jay1han/V2-Documents/Schema-global_4.png

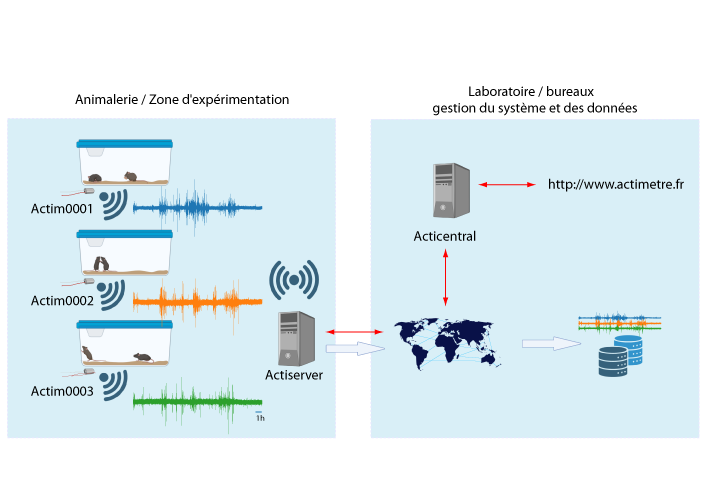
Schema-global_4.png
