jay1han/V2-Documents/V5 actimetre.FCStd

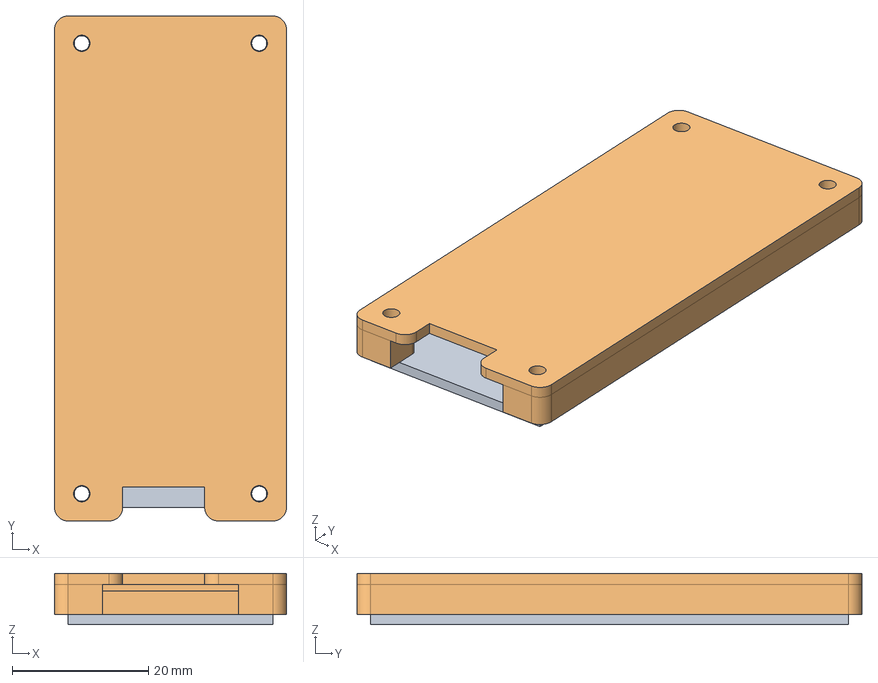
[picture p29: CAD file, 2025-03-25]
V5 actimetre.FCStd
34.0 x 74.0 x 7.50 mm
PCB
Cover
