jay1han/V2-Documents/Solo mini V5.FCStd

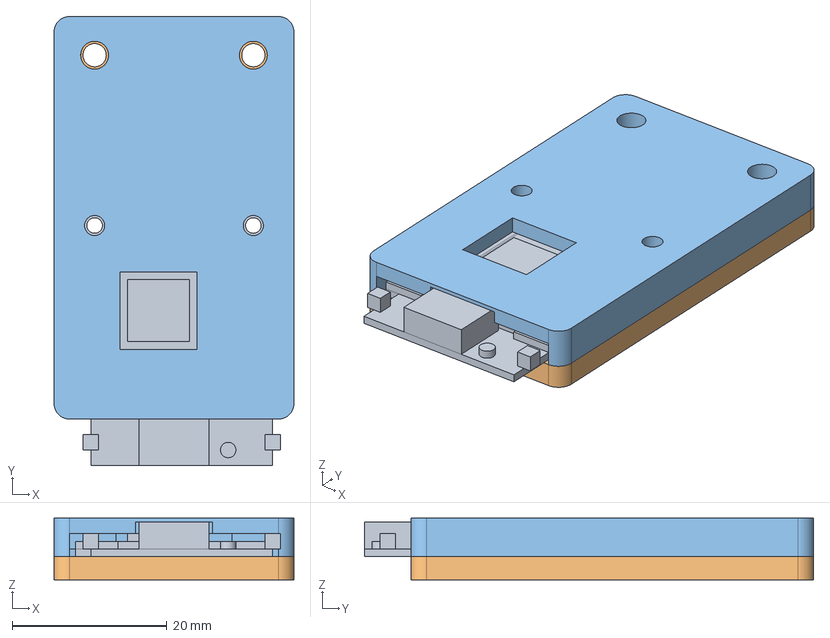
[picture p30: CAD file, 2025-03-25]
Solo mini V5.FCStd
31.0 x 58.0 x 8.00 mm
Mini
Plate
Cover
