jay1han/V2-Documents/S3 Zero.FCStd

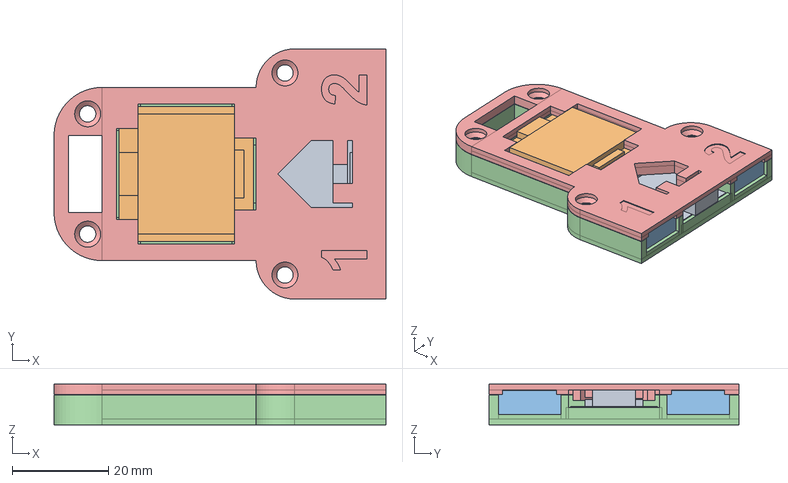
[picture p31: CAD file, 2025-02-12]
S3 Zero.FCStd
69.0 x 52.0 x 8.50 mm
S3
OLED
Connector1 x 2
Base
Cover
