jay1han/V2-Documents/Solo Zero V5.FCStd

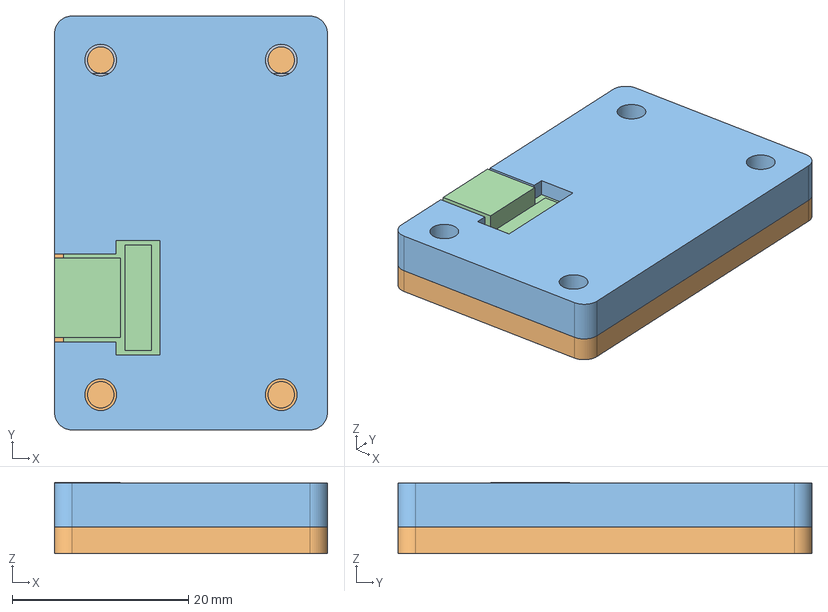
[picture p32: CAD file, 2025-02-12]
Solo Zero V5.FCStd
31.0 x 47.0 x 8.10 mm
Plate
Cover
S3
