jay1han/V2-Documents/Solo C3.FCStd

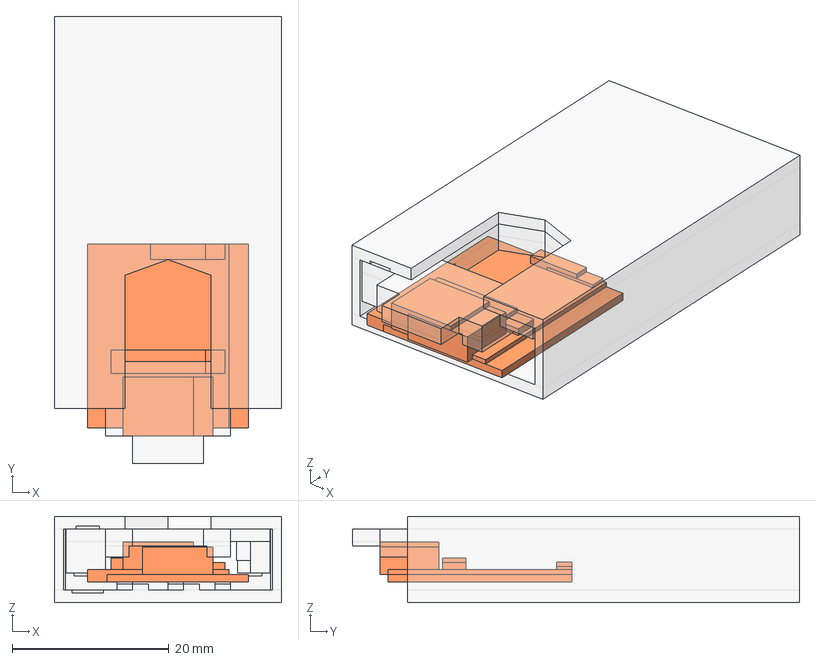
[picture p33: CAD file, 2024-05-24]
Solo C3.FCStd
29.0 x 57.0 x 11.0 mm
Supermini
C3
Sleeve
Tray
