jay1han/V2-Documents/V4.FCStd

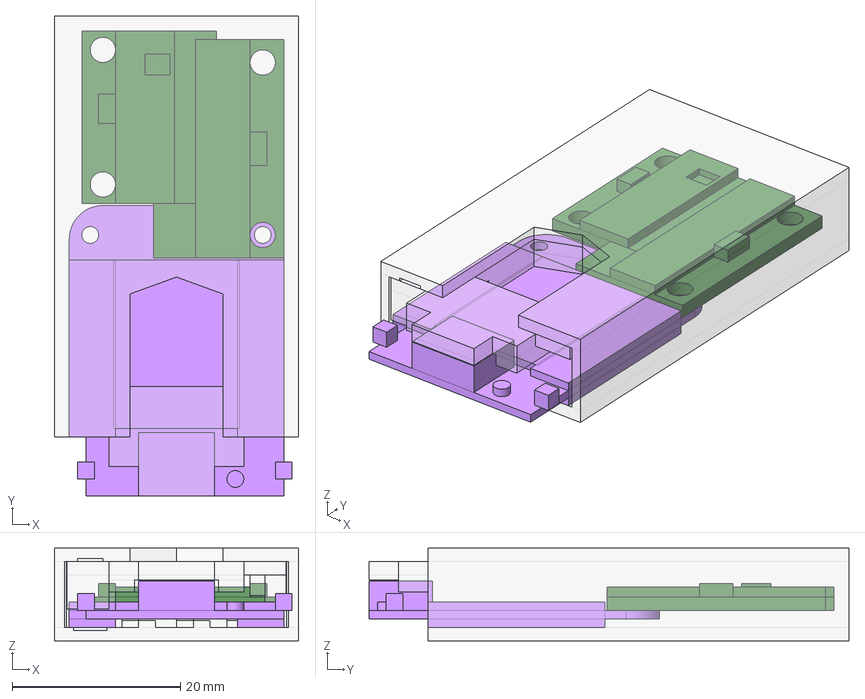
[picture p34: CAD file, 2024-05-09]
V4.FCStd
29.0 x 57.0 x 11.0 mm
Mini
Sleeve
Tray
