jay1han/V2-Documents/V3 mini.FCStd

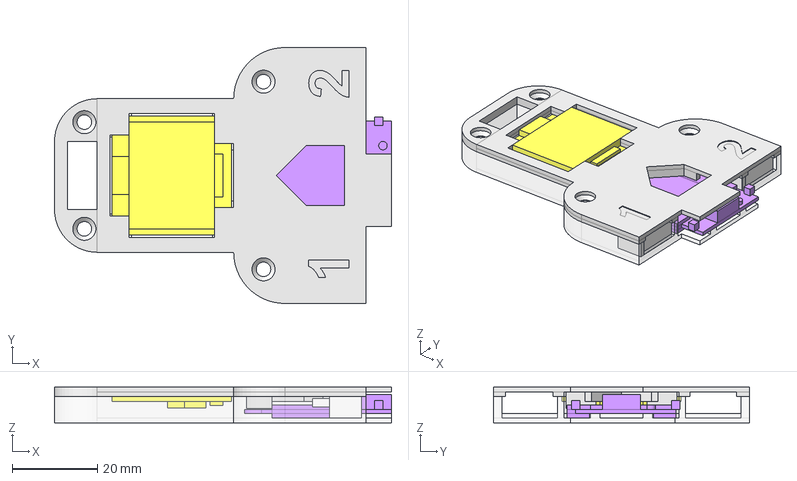
[picture p35: CAD file, 2024-04-23]
V3 mini.FCStd
79.0 x 60.0 x 8.40 mm
Base
Cover
OLED
Connector1 x 2
S3
