jay1han/V2-Documents/newbox.FCStd

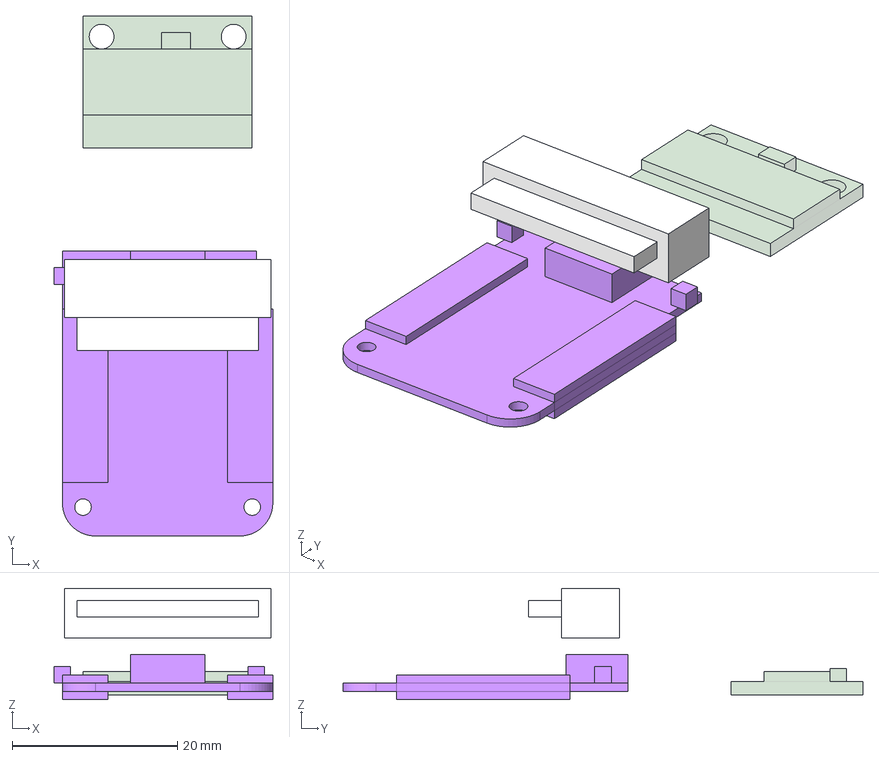
[picture p36: CAD file, 2024-03-25]
newbox.FCStd
26.5 x 63.0 x 13.5 mm
S3
Connectors
Sensor
