jay1han/V2-Documents/V3 backup.FCStd

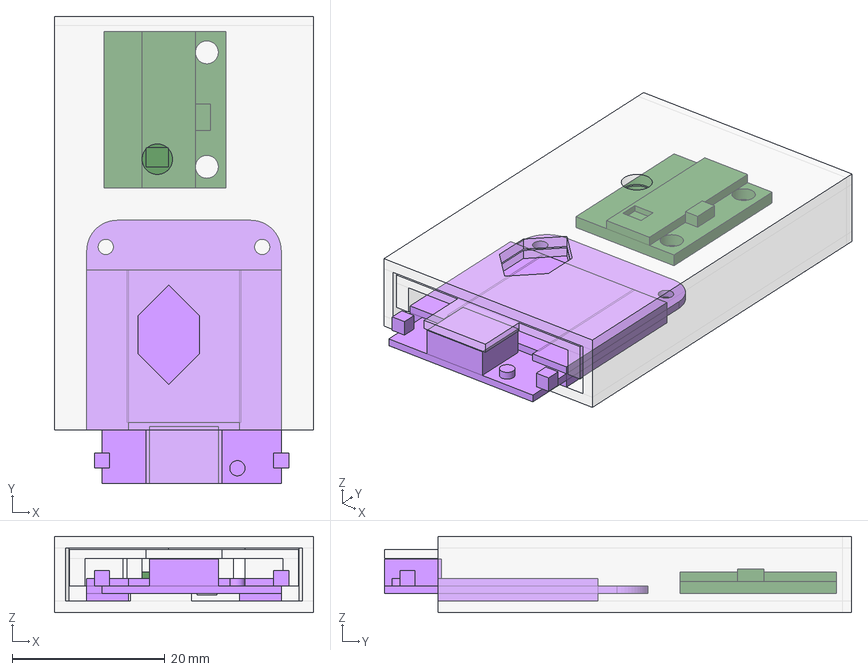
[picture p37: CAD file, 2024-03-22]
V3 backup.FCStd
34.0 x 61.2 x 10.0 mm
S3
Catch
Sleeve
