jay1han/V2-Documents/actimetre.FCStd

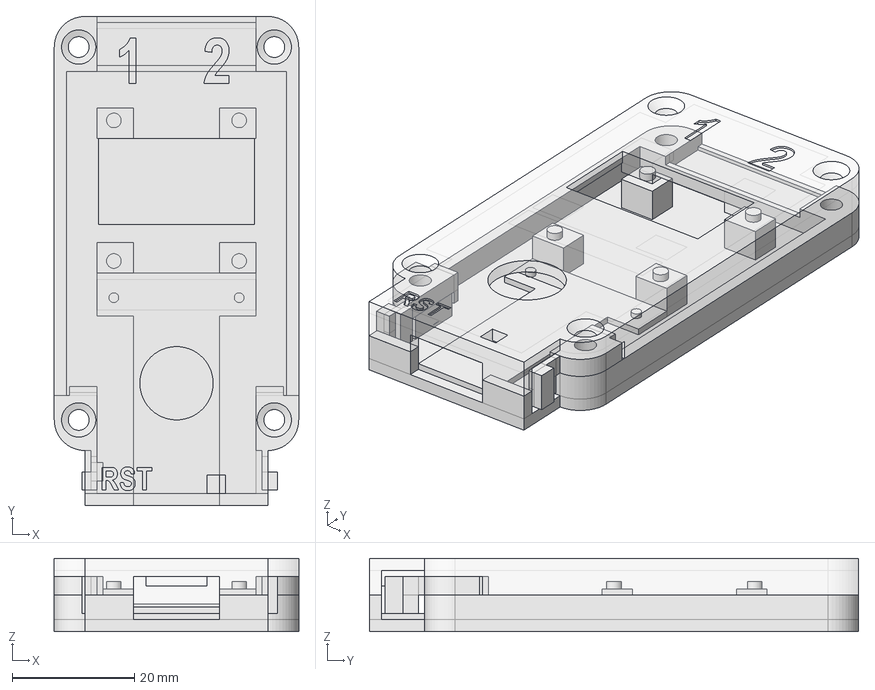
[picture p38: CAD file, 2024-03-05]
actimetre.FCStd
40.0 x 80.0 x 12.0 mm
Cover
Case001
Resetbuton
BootButton
