jay1han/V2-Documents/Solo mini.FCStd

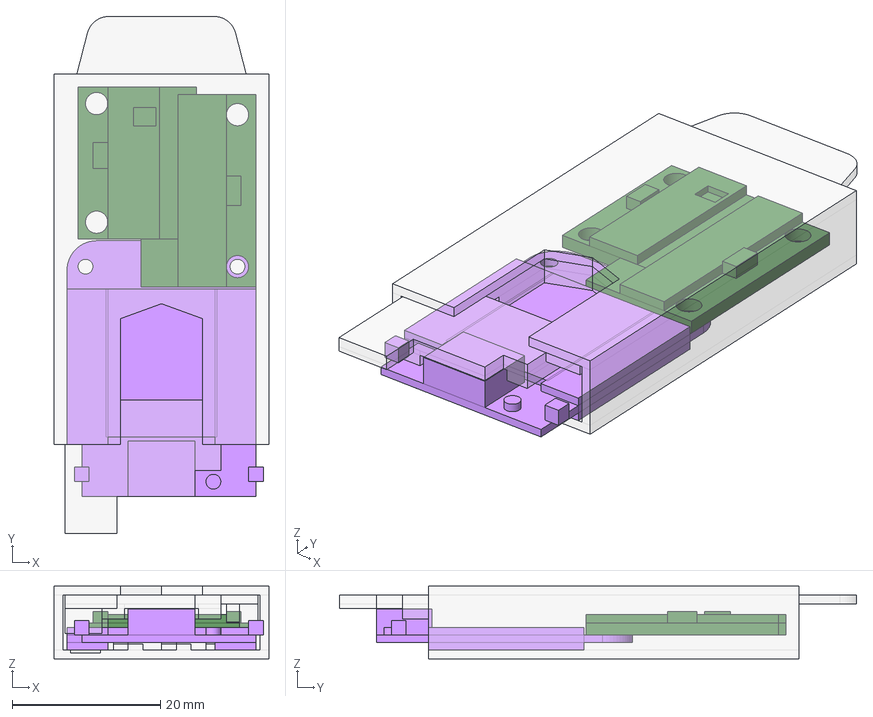
[picture p39: CAD file, 2024-05-26, an earlier design]
Solo mini.FCStd
29.0 x 69.8 x 9.80 mm
Mini
Sleeve
Tray
