jay1han/V2-Documents/V3.FCStd

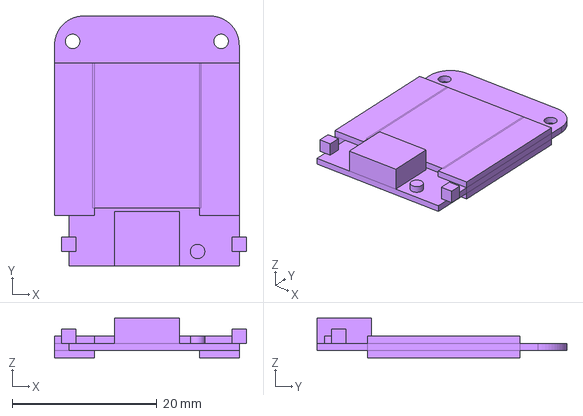
[picture p40: CAD file, 2024-04-23, an earlier design]
V3.FCStd
26.5 x 34.5 x 5.50 mm
