jay1han/V2-Documents/WiringsV5.pptx

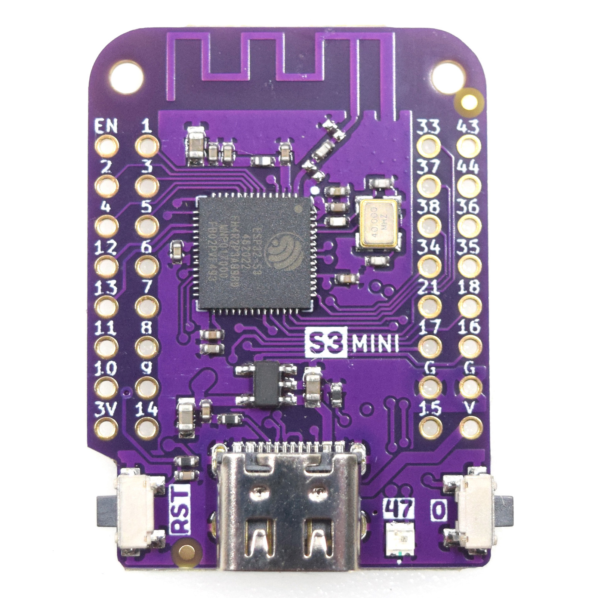
[picture p41: figure]
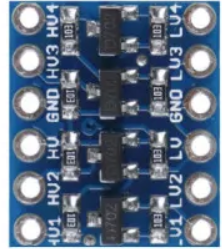
[picture p42: figure]

1K

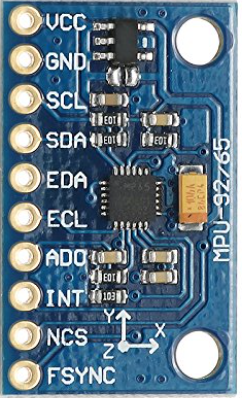
[picture p43: figure]

## Slide 2

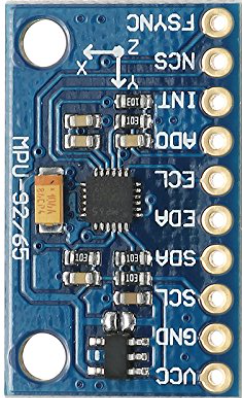
[picture p44: figure]
