jay1han/V2-Documents/Wirings.pptx

TOP_IMG

OLED Display
(I2C)

Sensors
1AB
(I2C)

Board ID

Sensors
2AB
(I2C)

3.3V

Ground

## Slide 2

## Slide 3


OLED Display
(I2C)

3.3V

Sensors
2AB
(I2C)

Sensors
1AB
(I2C)

Ground

## Slide 4

## Slide 5

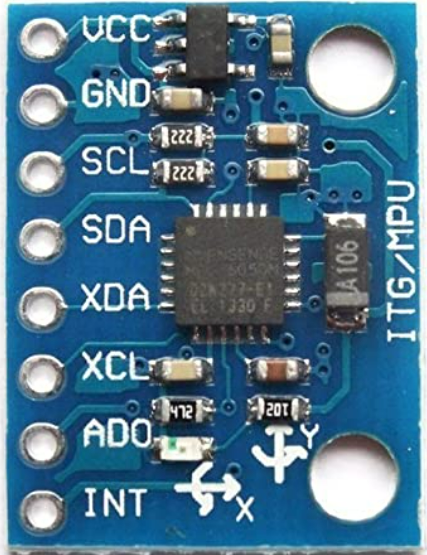
[picture p45: figure]

## Slide 6

B

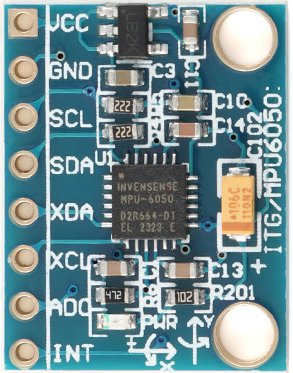
[picture p46: figure]

A

## Slide 7

New Box (V3)

Sensor
2AB
(I2C)

Sensor
1AB
(I2C)

## Slide 8

S3 supermini
(V3)

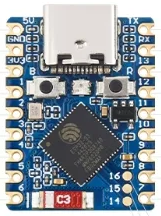
[picture p47: figure]

Pin 1 pull high

Sensor
1AB
(I2C)

Sensor
2AB
(I2C)
