jay1han/V2-Documents/(threads)

Thread 11 (2024-04-11):

ecrire un programme permettant e trier les fichiers de données

Bob690608, 2024-04-11:
Ce programme permettra de trier les milliers de fichiers de données contenus dans un répertoire en identifiant

- les actimetres et leur capteurs
- les séries de fichiers consécutifs (moins de x secondes entre la derniere ligne d'un fichier et la première ligne du suivant)
- la cage sur laquelle etait le capteur

jay1han, 2024-04-11:
More specifically:
- for each sensor, show the time segments corresponding to continuous measurement
- for each such segment, show the sampling frequency and data loss rate
- create a single file corresponding to a segment

On the other hand, relating segments with cage ID and project is left to the user

jay1han, 2024-05-01:
On estime qu'une interruption de moins de 5 minutes reste une acquisition continue, i.e. même projet et même cage.

jay1han, 2024-05-01:
Given a directory with files in a heap
- identify Actimetres and sensors
- clean up malformed lines
- isolate uniform acquisition segments (frequency, axes)
- clip & concatenate + rename
- create file list with metadata

Thread 15 (2024-04-11):

Clearinghouse: data file management

jay1han, 2024-04-11:
This issue is intended to obsolete #6 #3 #7 and is also related to #11

jay1han, 2024-04-11:
Requirement:
- Save data files securely and reliably to a designated network destination, then delete them from the Actiserver
- Put a given data file under a folder named after its corresponding project ID
- Further fan-out of the files to individuals or their computers is at the discretion of those individuals

Closed 2024-04-22.

Thread 16 (2024-04-11):

Detailed protocol for Actimetre management

jay1han, 2024-04-11:
Questions:
- How to create/modify/delete a project in the system?
- What are the key pieces of information attached to a project?
- How does an Actimetre get created/retired in the system?
- How does an Actimetre get assigned to/removed from a project?

Describe each operation in detail from the point of view of the actual operator

jay1han, 2024-04-11:
Assumptions:
- The Actimetre is the basic granularity for assignment to projects (not Actiservers, not individual sensors)
- The Actimetre system manager is responsible for adding/retiring Actimetres
- The project owner is responsible for managing the relationship between Actimetre-sensor and cage ID within the scope of his/her project

jay1han, 2024-04-20:
When an Actimetre is down, enable button to sync remaining files
When all files are cleared, Actimetre can be assigned to a different project

Closed 2024-04-22.

Thread 4 (2024-04-11):

Lancer un script externe à la clôture d'un fichier CSV

jay1han, 2024-04-11:
Nouvelle option de configuration SYNC_EXEC désignant le chemin complet du programme de sauvegarde de fichier. Ce programme sera appelé lorsqu'un fichier CSV est clos et doit être sauvegardé. Le programme est appelé avec un nom de fichier en paramètre. Ce fichier est présent dans le répertoire désigné par l'option REPO_ROOT (/media/actimetre par défaut).

jay1han, 2024-04-11:
Duplicate

jay1han, 2024-04-11:
Duplicate !!

Closed 2024-04-11.

Thread 5 (2024-04-11):

Dashboard shows the sensor model

jay1han, 2024-04-11:
In the format "1AB2AB" to show the attached sensors, lowercase a or b instead of uppercase signifies that the sensor is a MPU-6500 instead of a MPU-6050.
Note: the CSV file name is unchanged, will always use uppercase A or B

jay1han, 2024-04-17:
Branch "sensormodel" has been merged on Actimetre and Actiserver

Thread 6 (2024-04-11):

group datafiles in a subdirectory named after the project file

Bob690608, 2024-04-11:
Will help sorting datafiles

Bob690608, 2024-04-11:
- no risk to forget some datafiles in a given project
- datafiles unaffected (not normal) will appear at the root level
- the insertion of an actimeter in a project (or the removal from a project) will be a companion task to the management of mice cages

Bob690608, 2024-04-11:
eventually, when an actimeter is awakened after a time of inactivity (to be set in the anvironment variables), an alert is triggered on the dashboard to ask for the reassignation of the actimeter to the previous project

jay1han, 2024-04-11:
Need to refine the idea based on ultimate objective of this change.
Questions
- What if a project name changes
- What if the project name contains unacceptable characters for file path
- What is a good default for the time of inactivity

Alternate proposal: assign cage ID to sensor ID, then link cage ID to project. The CSV files will be stored in subfolders named after the cage ID. This assumes that there is a standard system for identifying cages. If there isn't please invent one.

jay1han, 2024-04-11:
This issue is obsoleted by #11

jay1han, 2024-04-11:
Consensus is to use the project ID (a number) as the folder name

Closed 2024-04-17.

Thread 7 (2024-04-11):

change data file names

Bob690608, 2024-04-11:
It will be more readable for a human like me to have the datestamp of the filename in a format more or less like %Y-%M-%D-%hh%mm%ss

jay1han, 2024-04-11:
To be more specific: YYYY-MM-DD-HHMMSS

Bob690608, 2024-04-11:
Prévoir aussi une interface (dashboard) pour insérer le numero de cage dans le nom des fichier etablir la correspondance Actimetre-capteur <-> ID_cage

Thread 23 (2024-04-20):

Test ESP32-C3

jay1han, 2024-04-20:

jay1han, 2024-04-20:
Single core, I2C at 400kHz. Can it handle 2 sensors at 1kHz or 1 at 4kHz?

jay1han, 2024-04-20:
Need special blinker

jay1han, 2024-04-22:
No hope here

Closed 2024-04-22.

Thread 24 (2024-04-20):

Actimetre file info in Project page

jay1han, 2024-04-20:

jay1han, 2024-04-21:
Manage files remaining from dead (unknown) Actimetre
Automatically call SYNC_EXE after one hour of inactivity
Trigger SYNC_EXE from dashboard

jay1han, 2024-04-22:
Test with sample SYNC_EXEC

jay1han, 2024-04-22:
When Actim goes out of Actis, finally clean up

jay1han, 2024-04-22:
Remove button and reset when Actim down

jay1han, 2024-04-22:
FIFO mixup: clear FIFO and count before resetting

jay1han, 2024-04-22:
Report initial state of /media/actimetre at startup

jay1han, 2024-04-22:
All done for v350

Closed 2024-04-22.

Thread 40 (2024-04-27):

SYNC_EXEC option behavior change

jay1han, 2024-04-27:
SYNC_EXEC is a plain string that is invoked as if typed in a console, with, if they are present, $0 will be replaced by the full path to the data file to sync, and $1 by the file name. For example, the configuration string “/usr/bin/mv $0 /dev/null” will result in the invocation of “/usr/bin/mv /media/actimetre/Actim0011-1A_2020-01-01_000000.csv /dev/null” while the configuration string “/usr/bin/mv $1 /dev/null” will result in the invocation of “/usr/bin/mv Actim0011-1A_2020-01-01_000000.csv /dev/null”. The file should be erased at the end of execution of this command before returning.

jay1han, 2024-04-27:
As per documentation

jay1han, 2024-04-27:
As per latest documentation, no change needed.

SYNC_EXEC is a plain string that is invoked as if typed in a console. If present, the substring $ will be replaced by the full path to the data file to sync. For example, the configuration string “/usr/bin/mv $ /dev/null” will result in the invocation of “/usr/bin/mv /media/actimetre/Project01/Actim0011-1A_2020-01-01_000000.csv /dev/null”. The file should be erased at the end of execution of this command before returning.

Closed 2024-04-27.

Thread 43 (2024-04-27):

Actiserver API for computation and data compression

jay1han, 2024-04-27:
Based on the following email:
```
from actiserver import actis_ext

def new_data(sensor_id, data):
    print(f'New data from sensor "{sensor}": {len(data)} items')
    # Traitement des données data

# Quelque part dans le processus principal
def main():
    actis_ext(sensor_id, len_data, new_data)
    # len_data is the number of data items new_data should be called with
    # call actis_ext(sensor_id) to de-register the callback
```

jay1han, 2024-04-28:
def actis_ext(sensor_id, period_ms, callback_fn)
# sensor_id is a string of the form "Actim0000-1A"
# period_ms is the period in millisecond
# callback_fn is a function of signature (sensor_id, sample_time, data), where sample_time is the datetime of the first element of data and data is a nparray of shape (period_ms, 6) of floats

jay1han, 2024-05-05:
Reuse SYNC_EXEC interface

jay1han, 2024-05-05:
case closed

Closed 2024-05-05.

Thread 48 (2024-04-30):

Fork S2/C3 version

jay1han, 2024-04-30:
Single core, so main loop alternates between reading fifo and sending packets.
Need to control time spent in data transfer so we don't overflow the fifo all the time.
All other protocols compatible to v35x

jay1han, 2024-05-04:
No RGB, no screen, so LED must blink with meaning.
Only 1kHz, only 1 sensor.

jay1han, 2024-05-08:
No need to fork, Solo version good to go

Closed 2024-05-08.

Thread 54 (2024-05-04):

"Stop"/"Start" buttons to stop/start acquisition on an actimetre

jay1han, 2024-05-04:
"Stop" stops generating data and triggers data sync on the Actiserver it's currently connected.
After sync is finished, the Actimetre can be assigned to a different project.
"Restart" restarts the Actimetre generating data.

In practice, the project owner will:
1. "Stop" the Actimetre on the Dashboard (Project page), and check all data has been synced
2. (optionally, from Dashboard) move the Actimetre to another project
3. Physically move the Actimetre to another cage, if needed
4. Restart it physically or click "Restart" the Actimetre on the Dashboard (Project page)

jay1han, 2024-05-05:
v380

Closed 2024-05-05.

Thread 59 (2024-05-05):

Move Restart button

jay1han, 2024-05-05:
Place next to name
Rename it Reboot

jay1han, 2024-05-05:
v371 of Acticentral

Closed 2024-05-05.

Thread 68 (2024-05-06):

BUG: Actiserver shows wrong sensor information

jay1han, 2024-05-06:
Seen in v385 vs. Actimetre 384.
Actimetre sends correct info and initial parse is good, but later retrieves old information and replaces actual

Closed 2024-05-11.

Thread 72 (2024-05-08):

Dead actimetres show as alive in main page

jay1han, 2024-05-08:

jay1han, 2024-05-09:
Also, remove Reboot and Button buttons if Actiserver is down

jay1han, 2024-05-11:
v415

Closed 2024-05-11.

Thread 73 (2024-05-08):

LED blinks erratically

jay1han, 2024-05-08:

jay1han, 2024-05-14:
Fixed v401

Closed 2024-05-14.

Thread 80 (2024-05-14):

Acticentral shows more sensors than reality

jay1han, 2024-05-14:

jay1han, 2024-05-21:
Likely solved by v400 refactoring

Closed 2024-05-21.

Thread 87 (2024-05-20):

Test behavior with sync error

jay1han, 2024-05-20:

jay1han, 2024-05-22:
1. Report the problem to Acticentral amd Owner
2. Retry sync at next file sync
3. Sync button?

Thread 104 (2024-08-26):

Atmometre

jay1han, 2024-08-26:
New device, based around S2 mini and
- Temperature and Humidity sensor
- Air quality sensor

Data gathering and device management are identical to Actimetre, but in a different category. Numbering is in 3 digits.
One project may contain none, one or more Atmometres.

In addition, an Atmometre may trigger an alert when certain thresholds are crossed. Alerts are triggered at regular intervals until the condition is cleared. Stopping the Atmometre will stop the alerts. Thresholds may be set through Acticentral.
