jay1han/V2-Documents/Schema global_4.pdf

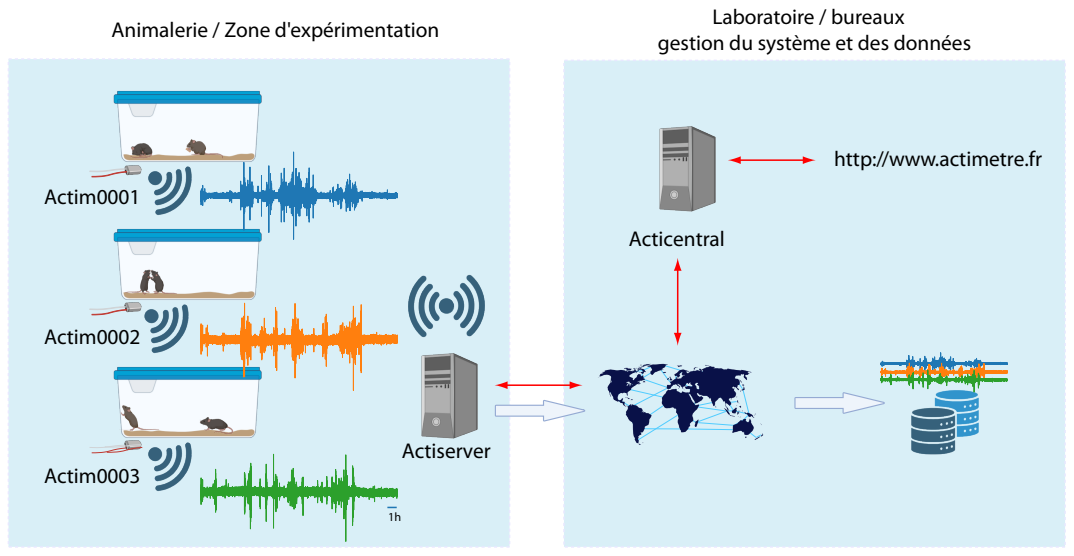
[picture p48: page 1]
Actiserver; Animalerie / Zone d'expérimentation; Laboratoire / bureaux; Acticentral; Actim0001; Actim0002; Actim0003

gestion du système et des données

http://www.actimetre.fr
