jay1han/V2-Documents/(commit log)

2023-05-24 Update Actimetre System.docx
    Updated ESP32 tool instructions
2023-06-03 Update cablage.txt
    One fewer to solder
2023-09-04 Fix I2C address
2024-02-28 new box
    [actimetre.FCStd]
2024-03-23 Hole back
    [V3 backup.FCStd, V3.FCStd]
2024-03-28 supermini boxes
    [V3 supermini.FCStd]
2024-04-04 Mass prod
    [V3 mini.FCStd, V3 supermini.FCStd]
2024-04-23 Updated installation documents
    [V3 mini.FCStd, V3 supermini.FCStd, V3.FCStd]
2024-05-05 V4
    Single-sensor ambidextrous
    [V4.FCStd]
2024-05-07 Updated wirings for Solos
2024-05-07 Remove useless pin
    [V4.FCStd]
2024-05-08 Board configuration
2024-05-08 Solo for mini
    [V4.FCStd]
2024-05-08 Switch connectors
    [V3 supermini.FCStd]
2024-05-08 Connector orientation
    [V4.FCStd]
2024-05-08 Screw hole
    [V4.FCStd]
2024-05-09 Tweak sleeve
    [V4.FCStd]
2024-05-18 Additional I2C ports for Solos
2024-05-26 easier to pull
    [Solo mini.FCStd]
2025-01-24 v5 (for the acquisition of the camera signals)
2025-03-25 update v5
    [Solo mini V5.FCStd, V5 actimetre.FCStd]
2025-03-26 Update WiringsV5.pptx
    V5 without camera
